jcobris/Vintage-Radio-1-public/(list of files, drawings)

Other design files:
docs/Circuit Board Layout/Circuit_Layoutv1.0.fzz
docs/Circuit Board Layout/Circuit_Layoutv1.0_bak.fzz
docs/Circuit Board Layout/Circuit_Layoutv1.1.fzz
docs/Circuit Board Layout/Circuit_Layoutv1.2.fzz
docs/Circuit Board Layout/Circuit_Layoutv2.0.fzz
