jcobris/Vintage-Radio-1-public/(commit log)

2026-02-15 Initial import (project + docs)
    Add Arduino sketch, tests, and documentation
    [Circuit_Layoutv1.0.fzz, Circuit_Layoutv1.0_bak.fzz, Circuit_Layoutv1.1.fzz, Circuit_Layoutv1.2.fzz]
2026-02-17 Pin 2 logic added
    No longer can send to MP3. Suspect issue with 2 serial connections
    [MP3.cpp, MP3.h, Vintage-Radio-1.ino]
2026-02-17 serial state fixed
    BT does not seem to send commands after init
    [Bluetooth.cpp, Bluetooth.h, MP3.cpp, Vintage-Radio-1.ino]
2026-02-18 code cleanup, seems ok but tuner problems possible
    [LedMatrix.cpp, MP3.cpp, Radio_Tuning.cpp, Vintage-Radio-1.ino]
2026-02-19 New prompt added
    [Circuit_Layoutv1.2.fzz]
2026-02-19 added stability
    STABLE_COUNT_GAP = 8 // was 4
    [Radio_Tuning.cpp]
2026-02-24 Prepare to Display light tweaking
    Remove high pitch noise
    [Circuit_Layoutv1.2.fzz]
2026-03-01 Added ALT switch
2026-03-04 added track skip switch
    [Config.h, MP3.cpp, MP3.h, Vintage-Radio-1.ino]
2026-03-08 Updated Calibration
2026-03-13 tweak strip leds
2026-04-04 looks good
    fixed spooky effect
    [LedMatrix.cpp, LedStrip.cpp, Vintage-Radio-1.ino]
2026-04-04 fixed strip stuck in christmas
    [LedStrip.cpp, Radio_Tuning.cpp]
